ganangadtyp/RTL_RISC-V/README.md

# PicoRV32-based Smartcard

This repository contains the source code of a **PicoRV32-based smartcard** project.

## Repository Structure

- **RISC-V SC/**  
  Contains the RTL source code for the smartcard.

- **Test_Bench/**  
  Testbench files for verifying the RTL design.

- **COE Files/**  
  Memory initialization files (`.coe`) used for simulation or synthesis.

- **RISC-V SC HAL/**  
  Utility files to build your own programs for the smartcard.
