ganangadtyp/RTL_RISC-V/Arsitektur/Arsitektur RISC-V SC/Arsitektur RISC-V SC.png

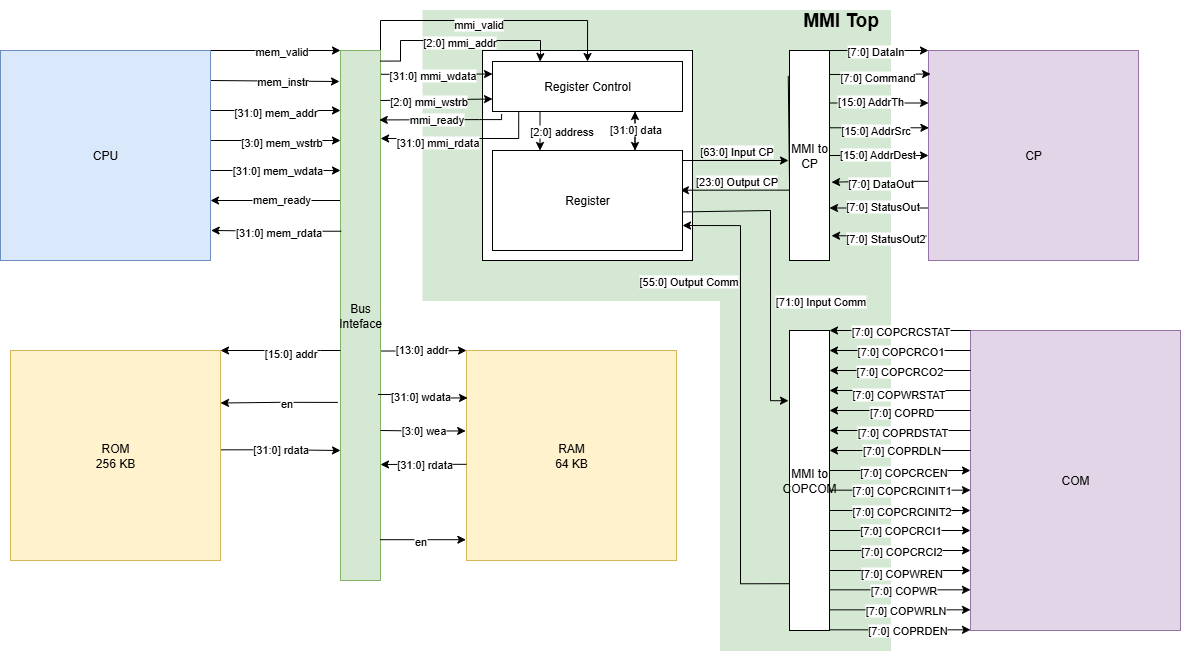
Arsitektur/Arsitektur RISC-V SC/Arsitektur RISC-V SC.png
