ganangadtyp/RTL_RISC-V/Arsitektur/Arsitektur SC-Arsitektur Coproc.png

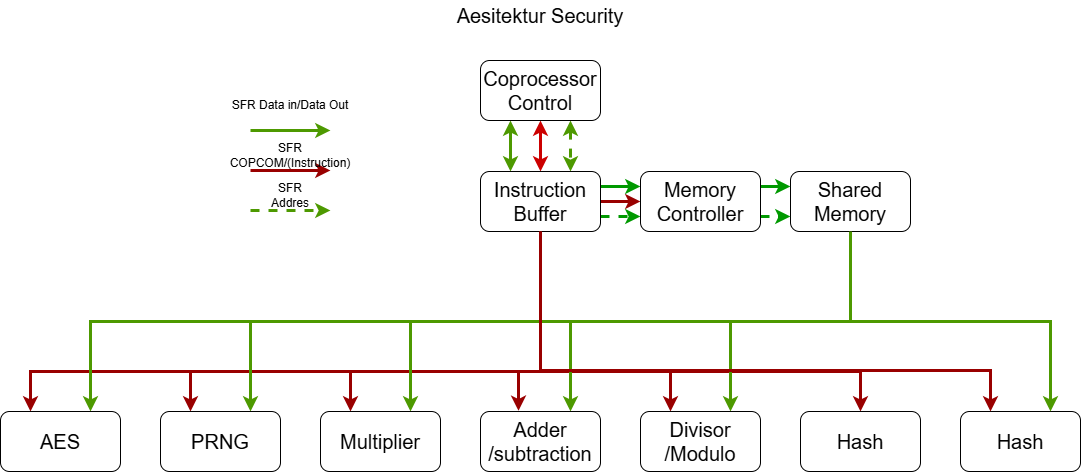
Arsitektur/Arsitektur SC-Arsitektur Coproc.png
