ganangadtyp/RTL_RISC-V/Arsitektur/Arsitektur SC-Arsitektur SC.png

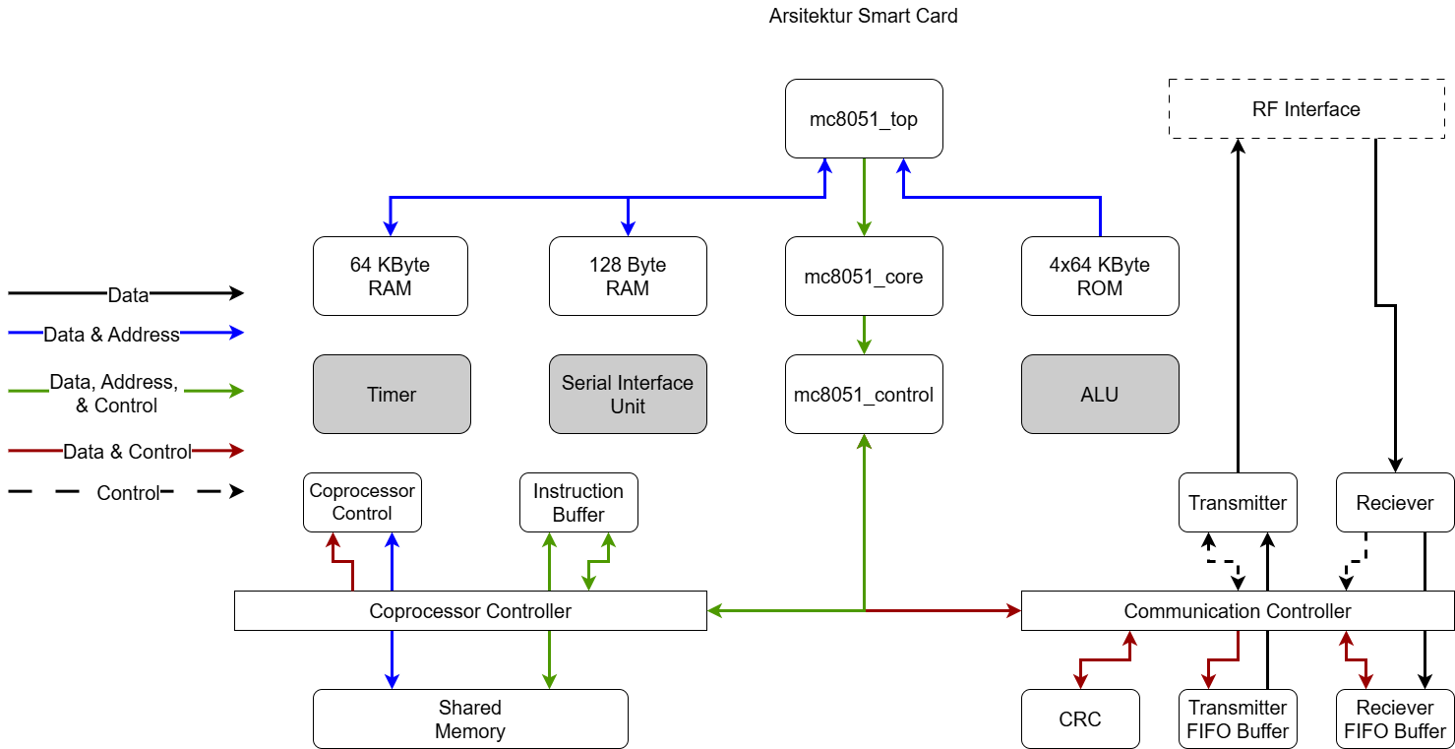
Arsitektur/Arsitektur SC-Arsitektur SC.png
