ganangadtyp/RTL_RISC-V/Arsitektur/Arsitektur SC-Communication Bus.png

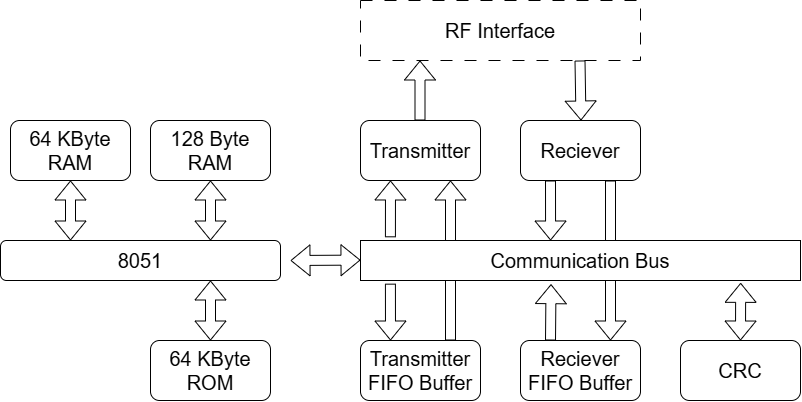
Arsitektur/Arsitektur SC-Communication Bus.png
