ganangadtyp/RTL_RISC-V/Arsitektur/Arsitektur SC-Shared Memory.png

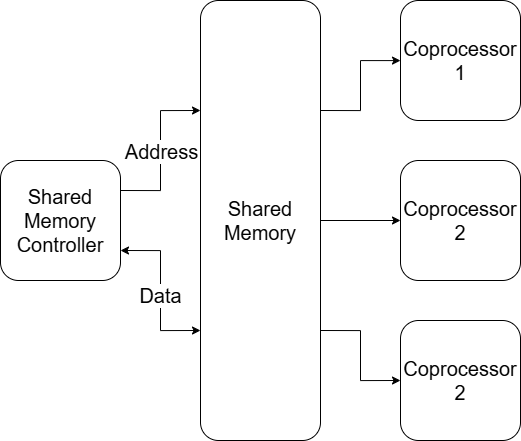
Arsitektur/Arsitektur SC-Shared Memory.png
