ganangadtyp/RTL_RISC-V/Test_Bench/README.md

## Testbench

- **smartcard_2_tb.v**  
  For Ver. 2 of hardware simulation.

  - **smartcard_3_tb.v**  
  For Ver. 3 of hardware simulation + stimulus of communication testing.

  - **wrapper2_tb**  
  Not Used
