ganangadtyp/RTL_RISC-V/RISC-V SC/Ver. 2/bus_interface_2.v

`timescale 1ns / 1ps
//////////////////////////////////////////////////////////////////////////////////
// Company: 
// Engineer: 
// 
// Create Date: 18.07.2025 13:20:16
// Design Name: 
// Module Name: bus_interface_2
// Project Name: 
// Target Devices: 
// Tool Versions: 
// Description: 
// 
// Dependencies: 
// 
// Revision:
// Revision 0.01 - File Created
// Additional Comments:
// 
//////////////////////////////////////////////////////////////////////////////////


module bus_interface_2 (
    input clk, reset,
    
    //CPU
    input mem_valid,
    input mem_instr,
    input [31:0] mem_addr,
    input [3:0] mem_wstrb,
    input [31:0] mem_wdata,
    output mem_ready,
    output [31:0] mem_rdata,

    //MMI
    output mmi_valid,
    output [2:0] mmi_addr,
    output [3:0] mmi_wstrb,
    input mmi_ready,
    output [31:0] mmi_wdata,
    input [31:0] mmi_rdata,

    //RAM
    output ram_en,
    output [3:0] ram_wea,
    output [13:0] ram_addr,
    output [31:0] ram_wdata,
    input [31:0] ram_rdata,

    //ROM
    output [15:0] rom_addr,
    input [31:0] rom_rdata,
    output rom_en
);

reg ram_ready, rom_ready;
reg [31:0] last_mem_rdata;

always @(posedge clk) begin
    if(reset)
        last_mem_rdata <= 32'd0;
    else
        last_mem_rdata <= mem_rdata;
end

//CPU
assign mem_ready = mmi_ready || rom_ready || ram_ready;
assign mem_rdata = rom_ready ? rom_rdata : ram_ready ? ram_rdata : mmi_ready? mmi_rdata : last_mem_rdata;

//MMI
//assign mmi_valid = (mem_valid && (!mem_instr) && mem_addr[31:5]  == 27'h0002000)? 1'd1 : 1'd0;
assign mmi_valid = (mem_valid && (!mem_instr) && mem_addr[19:16]  == 4'h4)? 1'd1 : 1'd0;
assign mmi_addr = mem_addr[4:2];
assign mmi_wstrb = mem_wstrb;
assign mmi_wdata = mem_wdata;

//RAM
//assign ram_en = (mem_valid && (!mem_instr) && ((mem_addr[31:16] == 16'h0004) || (mem_addr[31:16] == 16'h0005)))? 1'd1 : 1'd0;
assign ram_en = (mem_valid && (!mem_instr) && mem_addr[19:16] == 4'h5 )? 1'd1 : 1'd0;
assign ram_wea = mem_wstrb;
assign ram_addr = mem_addr[15:2];
assign ram_wdata = mem_wdata;

//Control RAM dan ROM
always @(posedge clk) begin
    if (!reset) begin
        //ram_ready <= mem_valid && ((mem_addr[31:16] == 16'h0004) || (mem_addr[31:16] == 16'h0005));
        //rom_ready <= mem_valid && (mem_addr[31:18] == 14'h0000);
        ram_ready <= ram_en;
        rom_ready <= rom_en; 
    end
    else begin
        ram_ready <= 1'd0;
        rom_ready <= 1'd0;
    end
end

//ROM
assign rom_en = (mem_valid && mem_instr && (mem_addr[19:16] == 4'h0 | mem_addr[19:16] == 4'h1 | mem_addr[19:16] == 4'h2 | mem_addr[19:16] == 4'h3 ))? 1'd1 : 1'd0;
assign rom_addr = mem_addr[17:2];
    
endmodule
