ganangadtyp/RTL_RISC-V/RISC-V SC/SC_04/CLA_4bit.v

`timescale 1ns / 1ps

module CLA_4bit(
  input [3:0]A, B, 
  input Cin,
  output [3:0] S,
  output Cout
);
  wire [3:0] Ci; // Carry intermediate for intermediate computation
  
  assign Ci[0] = Cin;
  assign Ci[1] = (A[0] & B[0]) | ((A[0]^B[0]) & Ci[0]);
  //assign Ci[2] = (A[1] & B[1]) | ((A[1]^B[1]) & Ci[1]); expands to
  assign Ci[2] = (A[1] & B[1]) | ((A[1]^B[1]) & ((A[0] & B[0]) | ((A[0]^B[0]) & Ci[0])));
  //assign Ci[3] = (A[2] & B[2]) | ((A[2]^B[2]) & Ci[2]); expands to
  assign Ci[3] = (A[2] & B[2]) | ((A[2]^B[2]) & ((A[1] & B[1]) | ((A[1]^B[1]) & ((A[0] & B[0]) | ((A[0]^B[0]) & Ci[0])))));
  //assign Cout  = (A[3] & B[3]) | ((A[3]^B[3]) & Ci[3]); expands to
  assign Cout  = (A[3] & B[3]) | ((A[3]^B[3]) & ((A[2] & B[2]) | ((A[2]^B[2]) & ((A[1] & B[1]) | ((A[1]^B[1]) & ((A[0] & B[0]) | ((A[0]^B[0]) & Ci[0])))))));

  assign S = A^B^Ci;
endmodule
