ganangadtyp/RTL_RISC-V/(commit log)

2025-07-16 Add files via upload
    Overall fixed system, version 1. -R&G
    [mmi_to_copcom.v, mmi_to_cp.v, mmi_top.v, ram.v]
2025-07-21 Create tabel data RTL
    Table of shared memory address mapping in the top_coprocessor_control
    [tabel data RTL.xlsx]
2025-08-15 Update smartcard_2.v Fix ISO14443_wrapper reset
    [smartcard_2.v]
2025-10-06 Update tabel data RTL
    [tabel data RTL.xlsx]
